beeverycreative/helloBEEprusa-hardware/helloBEEprusa-addon_printed_parts/statibilty_feet-middle_left.stl

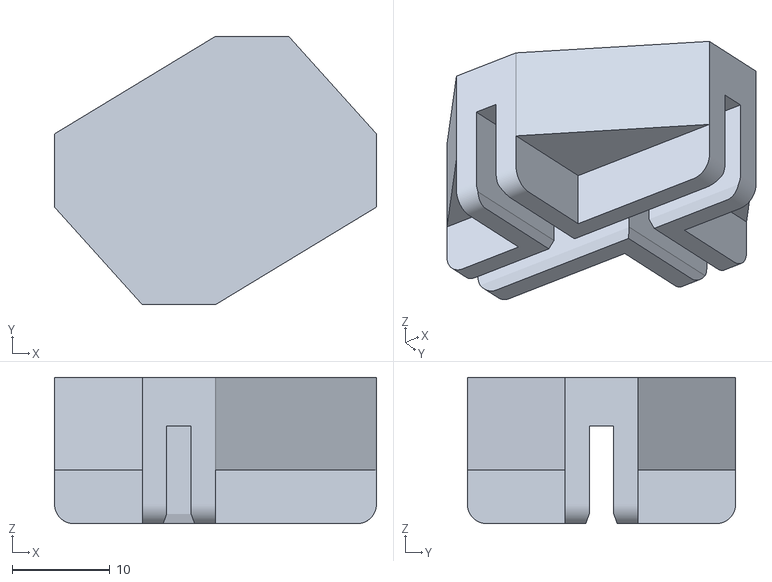
[picture p2: CAD file, 2015-11-10]
helloBEEprusa-addon_printed_parts/statibilty_feet-middle_left.stl
33.0 x 27.5 x 15.0
