beeverycreative/helloBEEprusa-hardware/helloBEEprusa-autocalibration_addon_printed_parts/Auto_level_arm.STL

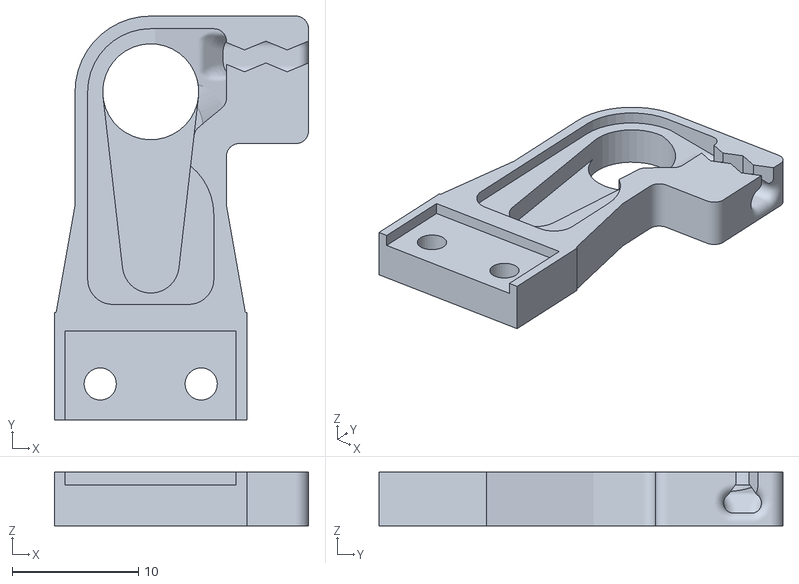
[picture p3: CAD file, 2018-11-13]
helloBEEprusa-autocalibration_addon_printed_parts/Auto_level_arm.STL
20.1 x 32.0 x 4.25
