beeverycreative/helloBEEprusa-hardware/helloBEEprusa-printed_parts/BLOWER.step

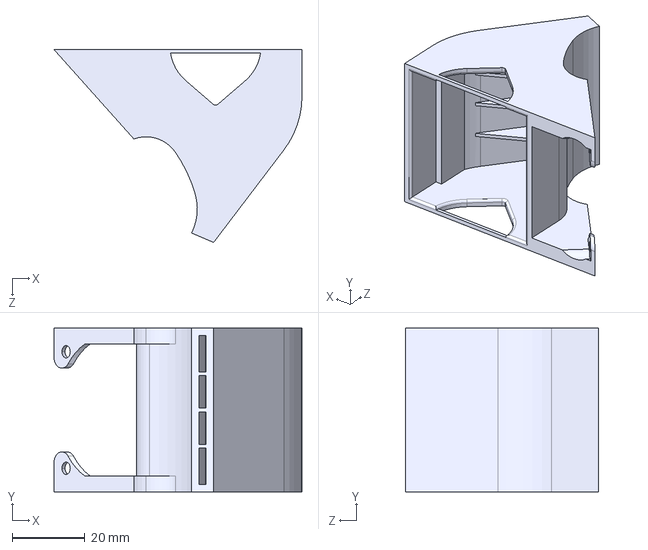
[picture p4: CAD file, 2016-04-29]
helloBEEprusa-printed_parts/BLOWER.step
68.1 x 45.0 x 53.0 mm
