beeverycreative/helloBEEprusa-hardware/helloBEEprusa-sources/Step/Assem_mesa.stp

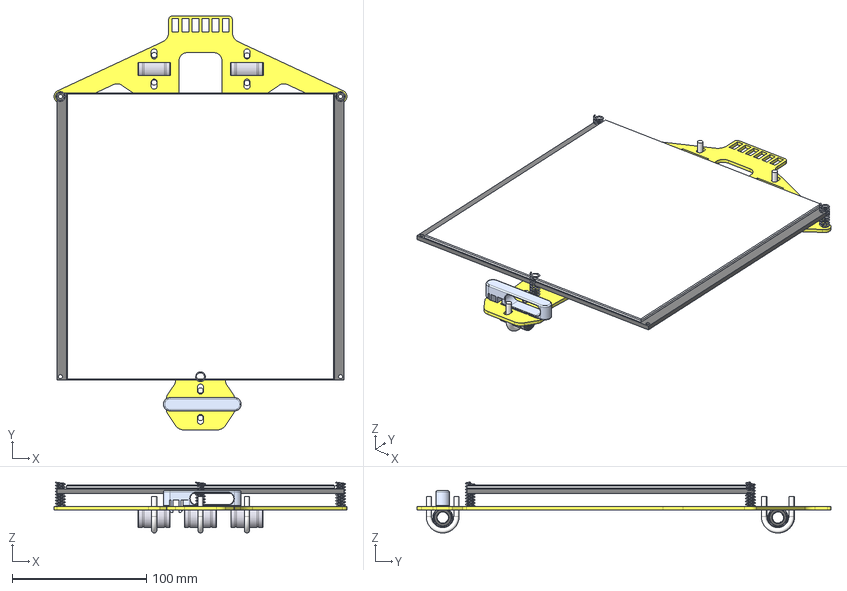
[picture p6: CAD file, 2016-10-18]
helloBEEprusa-sources/Step/Assem_mesa.stp
218.5 x 308.8 x 38.0 mm
endstop_lever_V2.1_03102016_0
Mola mesa_0 x 3
MK3_heated_bed_0
GrampoU_0 x 3
LU8MM_0 x 3
Base_mesa_0
Vidro_Temperado
