beeverycreative/helloBEEprusa-hardware/helloBEEprusa-autocalibration_addon_printed_parts/Auto_level_body.STL

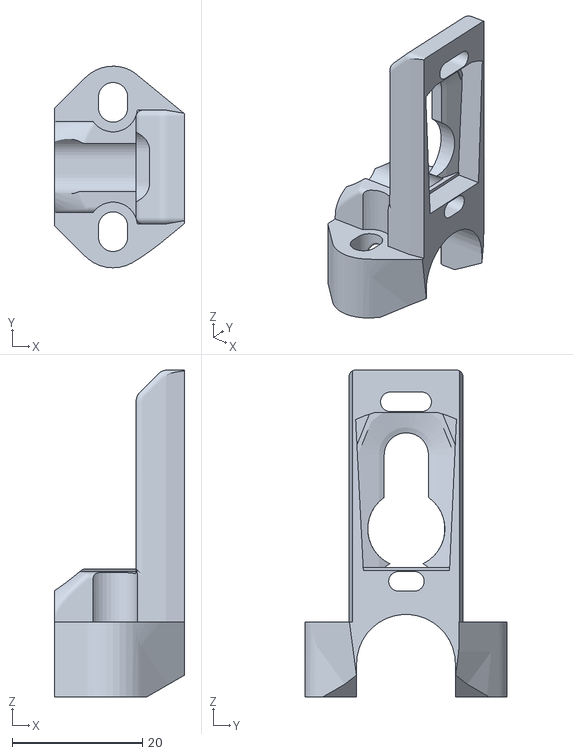
[picture p7: CAD file, 2018-11-13]
helloBEEprusa-autocalibration_addon_printed_parts/Auto_level_body.STL
20.0 x 31.0 x 50.3
