beeverycreative/helloBEEprusa-hardware/helloBEEprusa-printed_parts/XY_END_STOP_LEVER.step

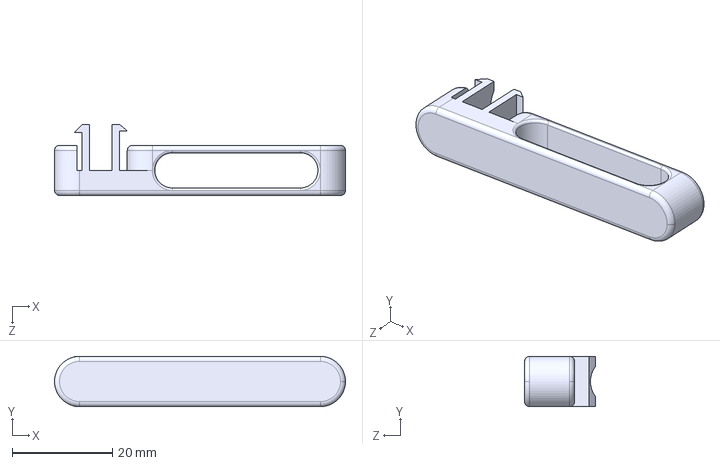
[picture p8: CAD file, 2016-04-29]
helloBEEprusa-printed_parts/XY_END_STOP_LEVER.step
58.0 x 10.0 x 14.2 mm
