beeverycreative/helloBEEprusa-hardware/helloBEEprusa-sources/dxf e dwg/Planificação HelloBeePrusa_V4.DXF

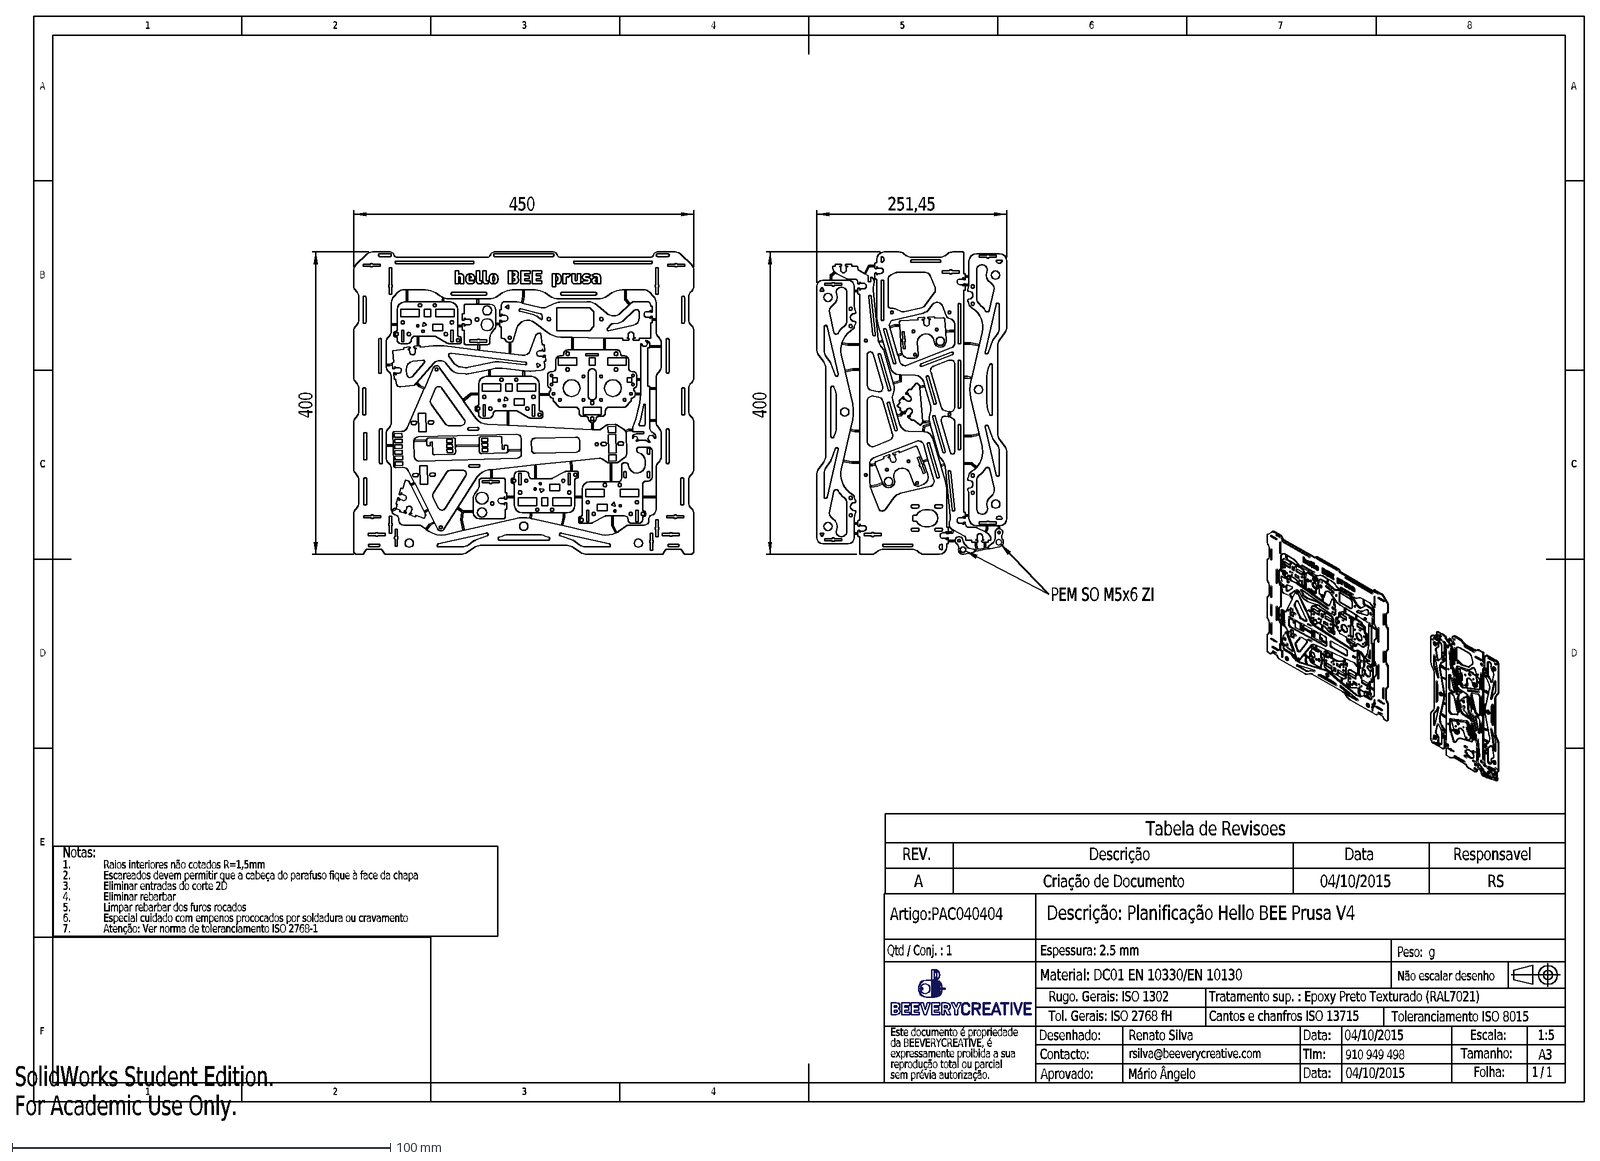
[picture p9: CAD file, 2016-10-18]
helloBEEprusa-sources/dxf e dwg/Planificação HelloBeePrusa_V4.DXF
Notas:
Raios interiores não cotados R=1,5mm
1.
Escareados devem permitir que a cabeça do parafuso fique à face da chapa
2.
Eliminar entradas do corte 2D
3.
Eliminar rebarbar
4.
Limpar rebarbar dos furos rocados
5.
Especial cuidado com empenos prococados por soldadura ou cravamento
6.
Atenção: Ver norma de toleranciamento ISO 2768-1
7.
D
E
F
C
1
2
3
4
B
A
5
6
7
8
Peso: g
Material: DC01 EN 10330/EN 10130
A3
1 / 1
1:5
Folha:
Tamanho:
Escala:
Este documento é propriedade
da BEEVERYCREATIVE, é
expressamente proibida a sua
reprodução total ou parcial
sem prévia autorização.
Desenhado:
Contacto:
Aprovado:
Data:
Tlm:
Qtd / Conj. : 1
Toleranciamento ISO 8015
Tol. Gerais: ISO 2768 fH
Cantos e chanfros ISO 13715
Rugo. Gerais: ISO 1302
Tratamento sup. : Epoxy Preto Texturado (RAL7021)
Artigo:PAC040404
Descrição: Planificação Hello BEE Prusa V4
Não escalar desenho
04/10/2015
Espessura: 2.5 mm
Renato Silva
rsilva@beeverycreative.com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
