beeverycreative/helloBEEprusa-hardware/helloBEEprusa-addon_printed_parts/stability_feet-corner.stl

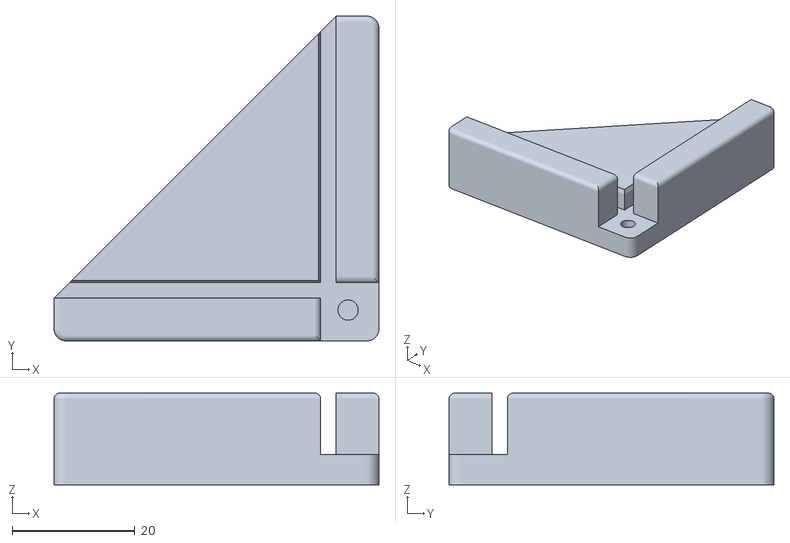
[picture p10: CAD file, 2015-11-10]
helloBEEprusa-addon_printed_parts/stability_feet-corner.stl
53.0 x 53.0 x 15.0
