beeverycreative/helloBEEprusa-hardware/helloBEEprusa-printed_parts/ENDSTOP_SUPORT.step

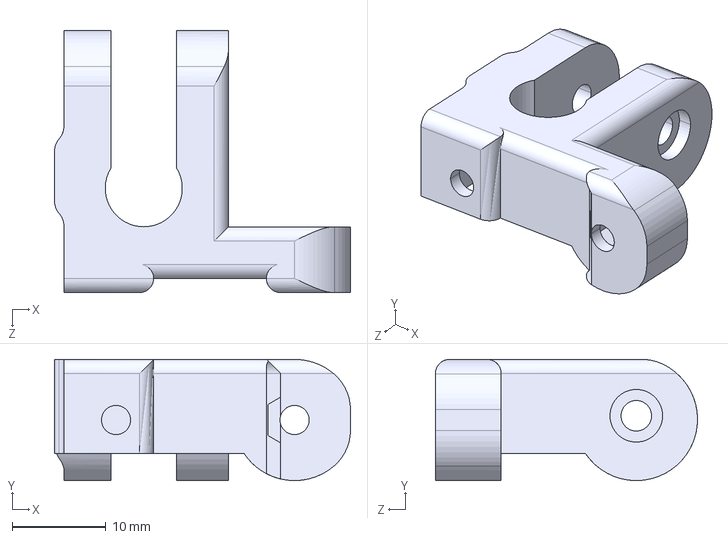
[picture p11: CAD file, 2016-04-29]
helloBEEprusa-printed_parts/ENDSTOP_SUPORT.step
31.5 x 12.9 x 27.9 mm
