beeverycreative/helloBEEprusa-hardware/helloBEEprusa-sources/dxf e dwg/Planificação HelloBeePrusa_V3 - Principal.DXF

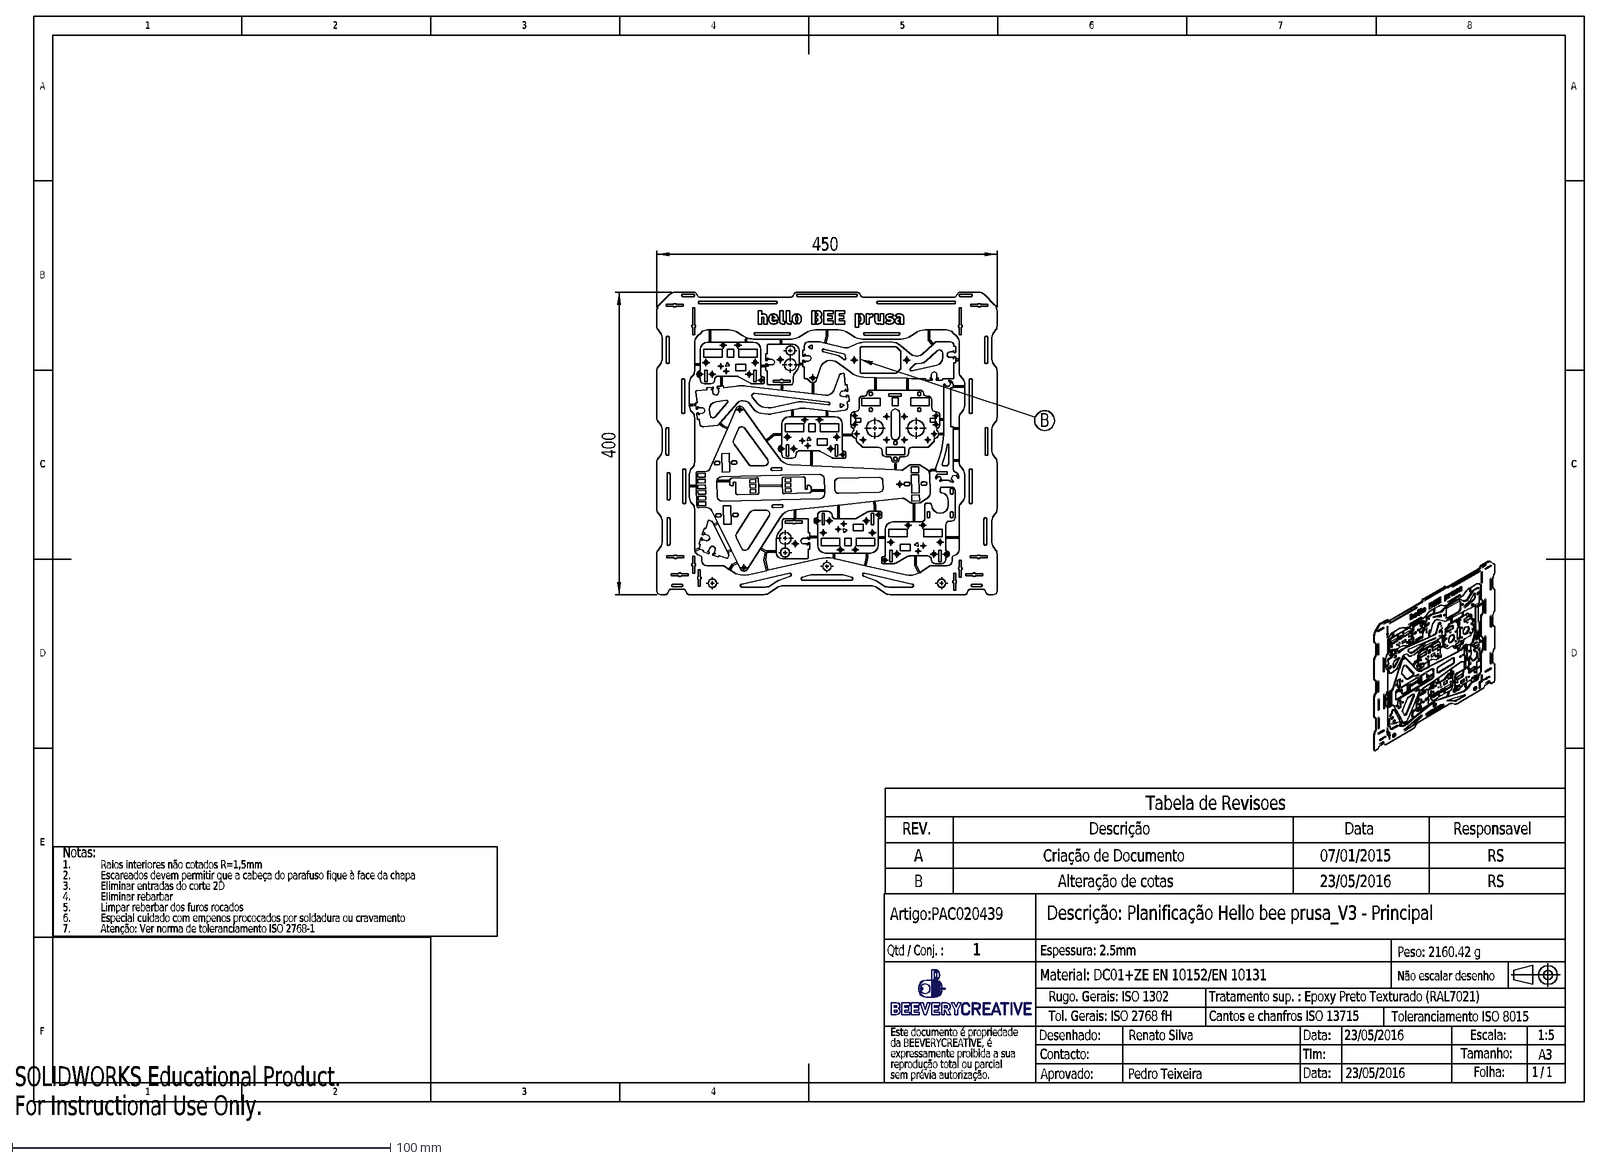
[picture p12: CAD file, 2016-10-18]
helloBEEprusa-sources/dxf e dwg/Planificação HelloBeePrusa_V3 - Principal.DXF
Notas:
Raios interiores não cotados R=1,5mm
1.
Escareados devem permitir que a cabeça do parafuso fique à face da chapa
2.
Eliminar entradas do corte 2D
3.
Eliminar rebarbar
4.
Limpar rebarbar dos furos rocados
5.
Especial cuidado com empenos prococados por soldadura ou cravamento
6.
Atenção: Ver norma de toleranciamento ISO 2768-1
7.
D
E
F
C
1
2
3
4
B
A
5
6
7
8
Peso: 2160.42 g
Material: DC01+ZE EN 10152/EN 10131
A3
1 / 1
1:5
Folha:
Tamanho:
Escala:
Este documento é propriedade
da BEEVERYCREATIVE, é
expressamente proibida a sua
reprodução total ou parcial
sem prévia autorização.
Desenhado:
Contacto:
Aprovado:
Data:
Tlm:
Qtd / Conj. :
Toleranciamento ISO 8015
Tol. Gerais: ISO 2768 fH
Cantos e chanfros ISO 13715
Rugo. Gerais: ISO 1302
Tratamento sup. : Epoxy Preto Texturado (RAL7021)
Artigo:PAC020439
Descrição: Planificação Hello bee prusa_V3 - Principal
Não escalar desenho
23/05/2016
Espessura: 2.5mm
Renato Silva
Pedro Teixeira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
