beeverycreative/helloBEEprusa-hardware/helloBEEprusa-sources/Step/Assem_eixo_X.stp

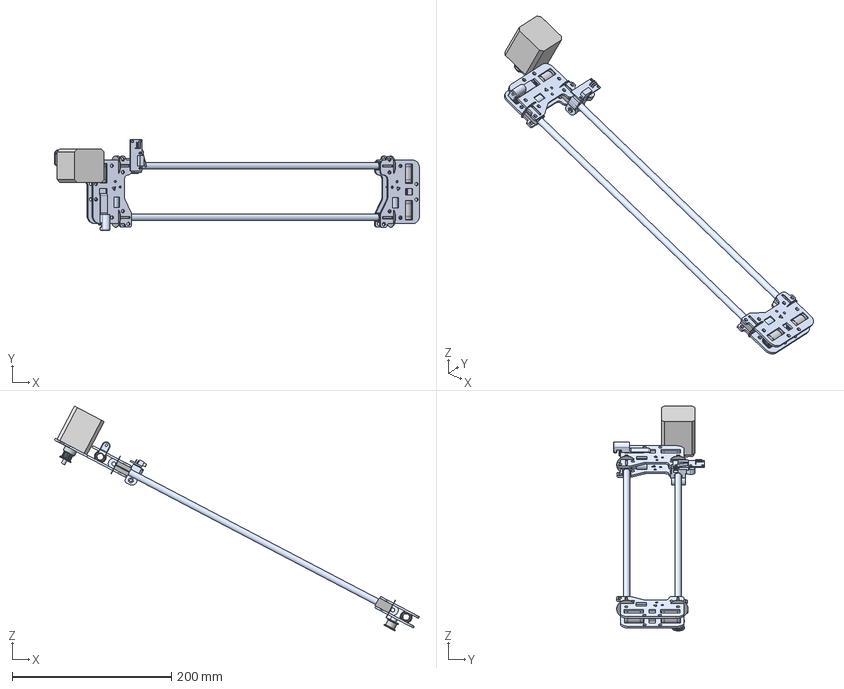
[picture p13: CAD file, 2016-10-18]
helloBEEprusa-sources/Step/Assem_eixo_X.stp
458.4 x 114.0 x 282.4 mm
Pulley_GT2_20_Tooth_0
endstop_suport_V2_23102015_0
endstop_0
7.0.2 - Polia_livre_0
Rolamento_638_4_2Z_2_03_0
endstop_lever_V2_ajustavel_03102016_1
Femea_igus_1 x 2
Espacador_Essentra_L7xd4.3xD8_0
LU8MM_1 x 4
Placa_Eixo_X1_1 x 3
Placa_Eixo_X3_1
Motor_Nema17_SY42STH47-1684A_0
Guia_M8_XPRT_1 x 2
Suporte_guias_1 x 4
