beeverycreative/helloBEEprusa-hardware/helloBEEprusa-printed_parts/ADJUSTMENT_FOR_BEARING_COVER.step

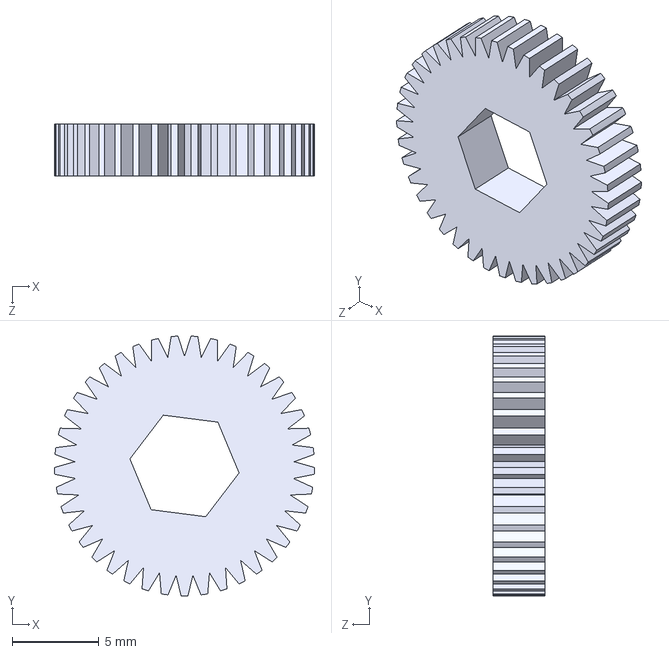
[picture p14: CAD file, 2016-04-29]
helloBEEprusa-printed_parts/ADJUSTMENT_FOR_BEARING_COVER.step
15.0 x 15.0 x 3.00 mm
