beeverycreative/helloBEEprusa-hardware/helloBEEprusa-printed_parts/Z_SUPPORT_RIGHT.step

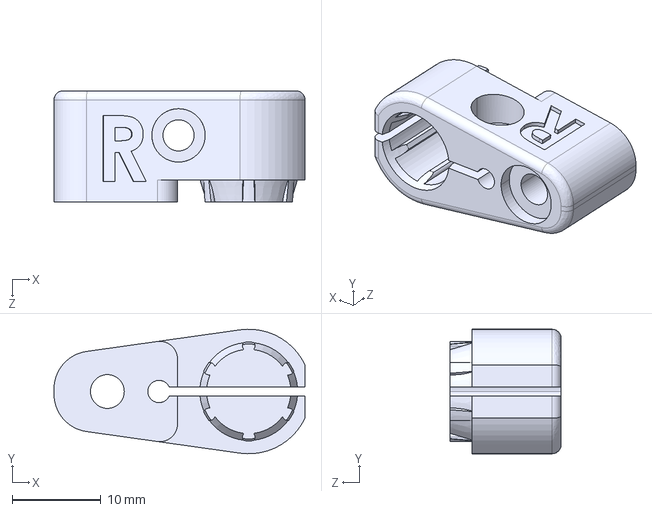
[picture p15: CAD file, 2016-04-29]
helloBEEprusa-printed_parts/Z_SUPPORT_RIGHT.step
28.2 x 14.0 x 12.5 mm
