beeverycreative/helloBEEprusa-hardware/helloBEEprusa-printed_parts/CLAMP.step

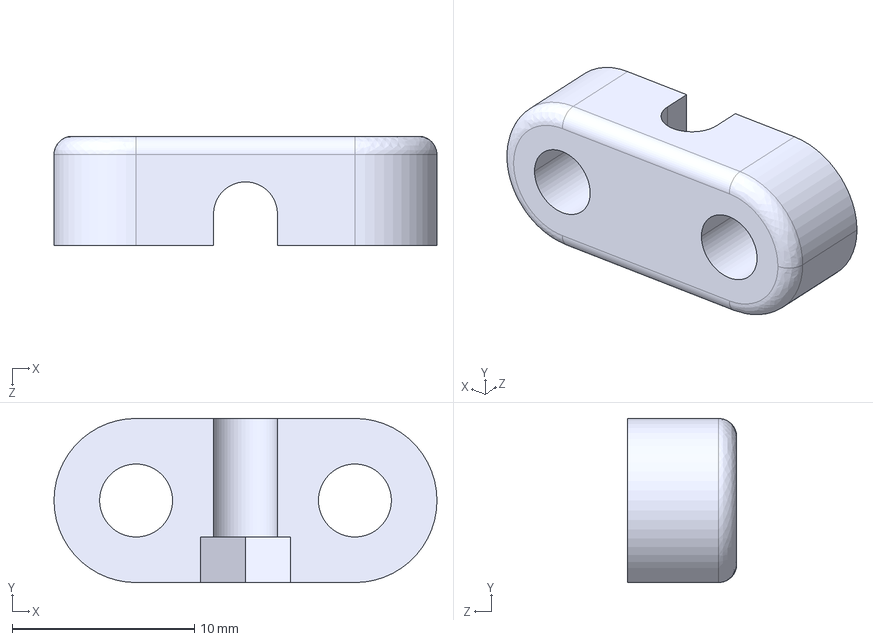
[picture p16: CAD file, 2016-04-29]
helloBEEprusa-printed_parts/CLAMP.step
21.0 x 9.00 x 6.00 mm
