beeverycreative/helloBEEprusa-hardware/helloBEEprusa-addon_printed_parts/enclosure_for_electronics-V4.stl

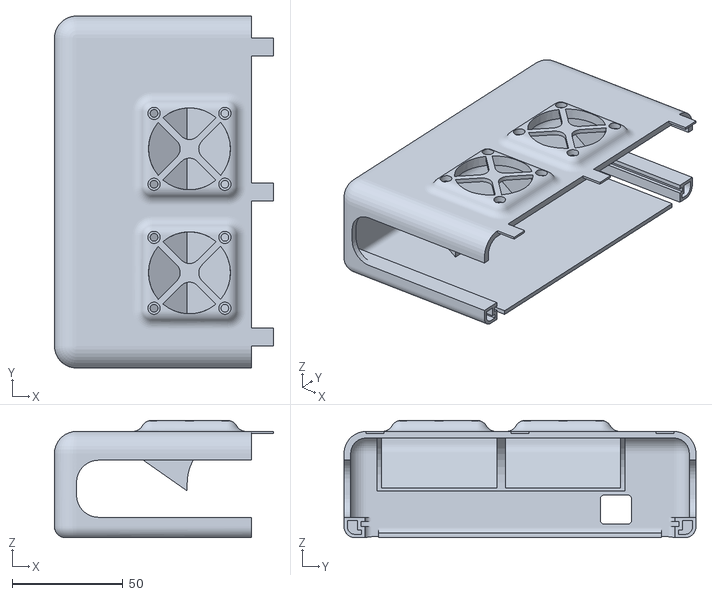
[picture p17: CAD file, 2015-11-04]
helloBEEprusa-addon_printed_parts/enclosure_for_electronics-V4.stl
99.0 x 159.0 x 53.0
