beeverycreative/helloBEEprusa-hardware/helloBEEprusa-printed_parts/DISPLAY_SPACER.step

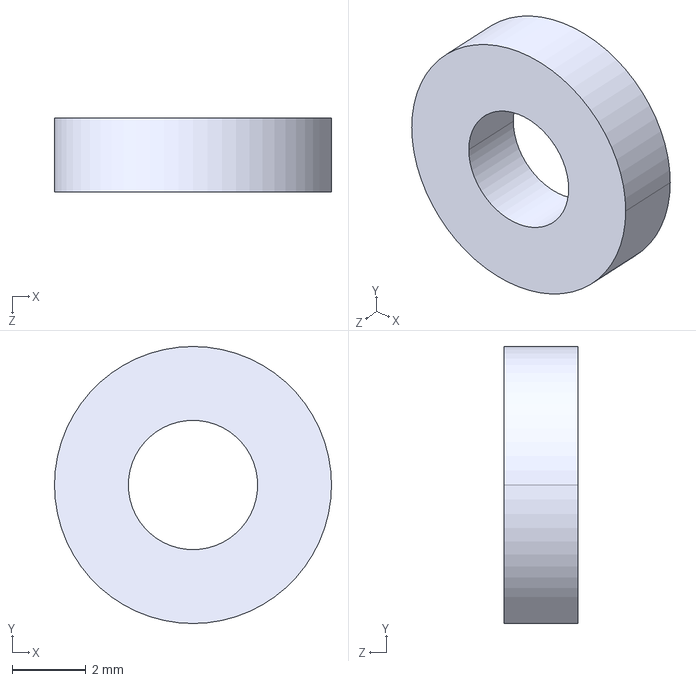
[picture p18: CAD file, 2016-04-29]
helloBEEprusa-printed_parts/DISPLAY_SPACER.step
7.50 x 7.50 x 2.00 mm
