beeverycreative/helloBEEprusa-hardware/helloBEEprusa-addon_printed_parts/two_spools_holder-v5.stl

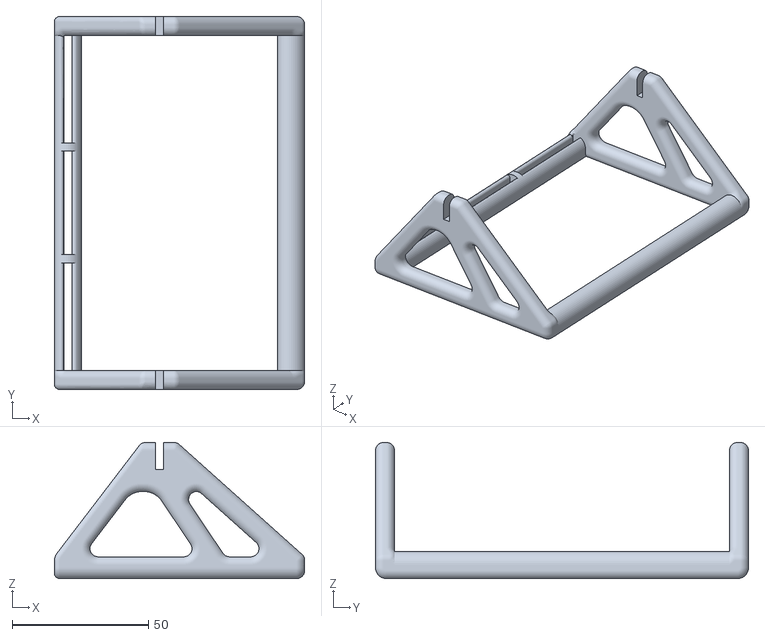
[picture p19: CAD file, 2015-08-05]
helloBEEprusa-addon_printed_parts/two_spools_holder-v5.stl
92.0 x 137.0 x 50.0
