beeverycreative/helloBEEprusa-hardware/helloBEEprusa-printed_parts/PCB_SPACER.step

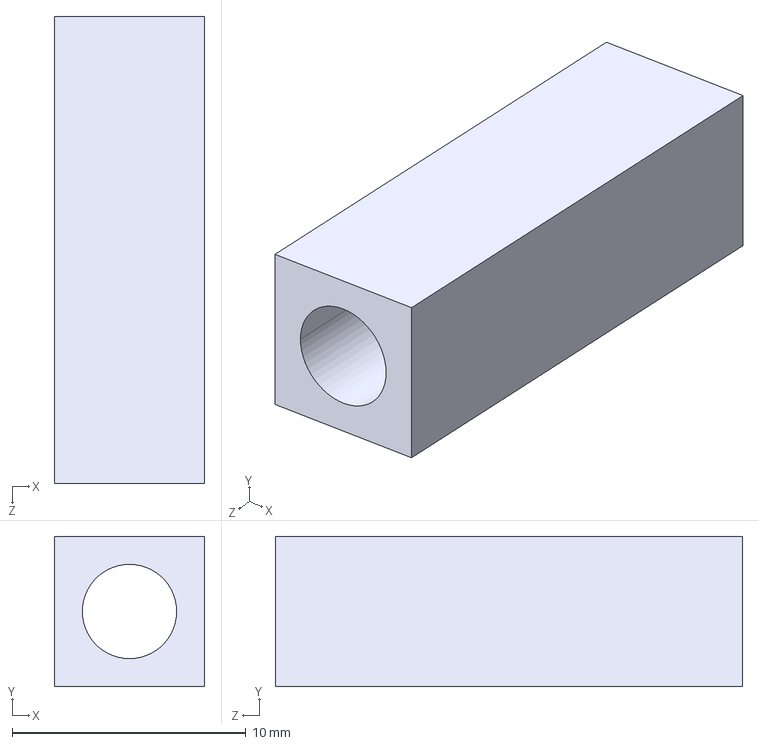
[picture p20: CAD file, 2016-04-29]
helloBEEprusa-printed_parts/PCB_SPACER.step
6.44 x 6.44 x 20.0 mm
