beeverycreative/helloBEEprusa-hardware/helloBEEprusa-addon_printed_parts/lcd_support-v5.stl

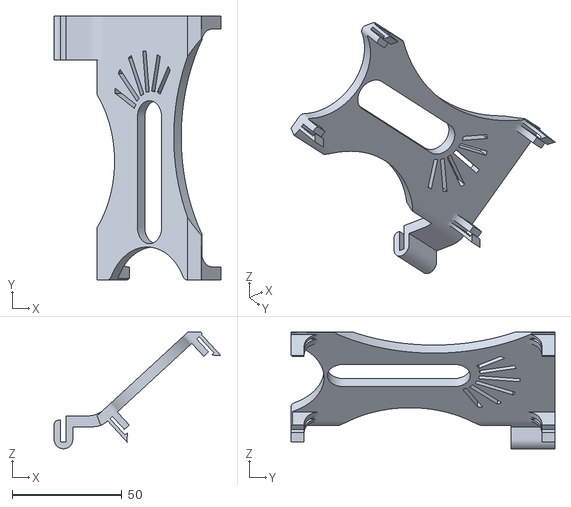
[picture p21: CAD file, 2015-08-05]
helloBEEprusa-addon_printed_parts/lcd_support-v5.stl
75.8 x 120.0 x 53.0
