beeverycreative/helloBEEprusa-hardware/helloBEEprusa-printed_parts/Z_AXIS_SUPPORT.step

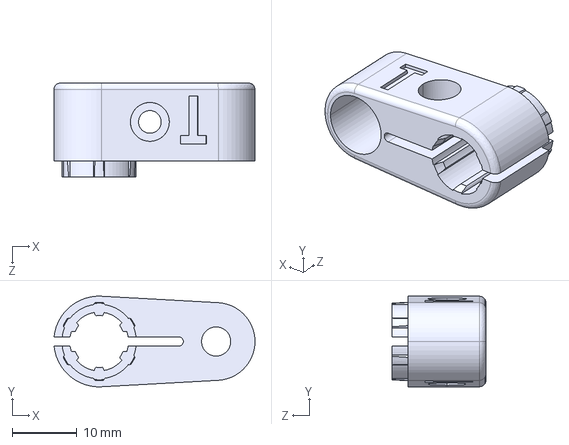
[picture p22: CAD file, 2016-04-29]
helloBEEprusa-printed_parts/Z_AXIS_SUPPORT.step
31.0 x 14.0 x 14.5 mm
