beeverycreative/helloBEEprusa-hardware/helloBEEprusa-addon_printed_parts/logo-hello.stl

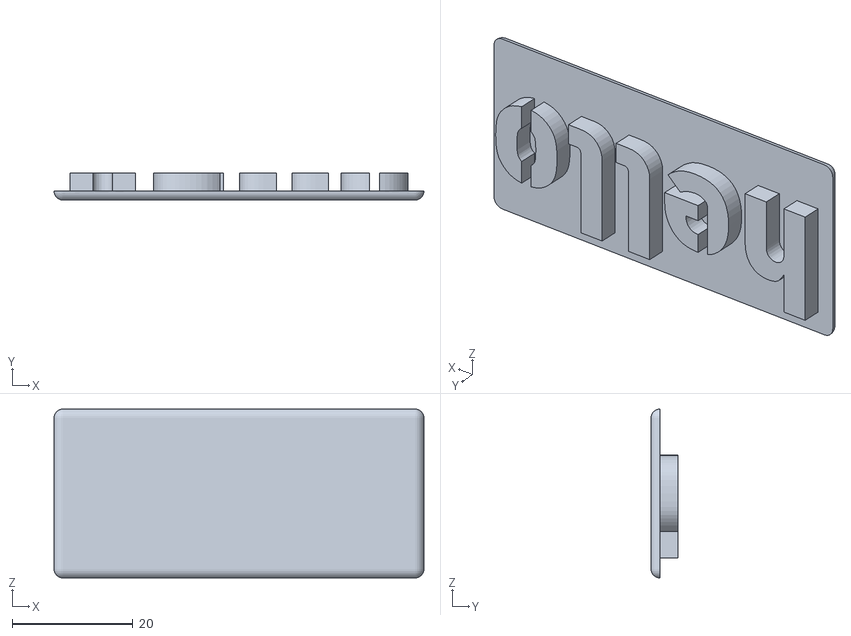
[picture p23: CAD file, 2015-08-05]
helloBEEprusa-addon_printed_parts/logo-hello.stl
61.3 x 4.50 x 28.0
