beeverycreative/helloBEEprusa-hardware/helloBEEprusa-printed_parts/X_SUPPORT.step

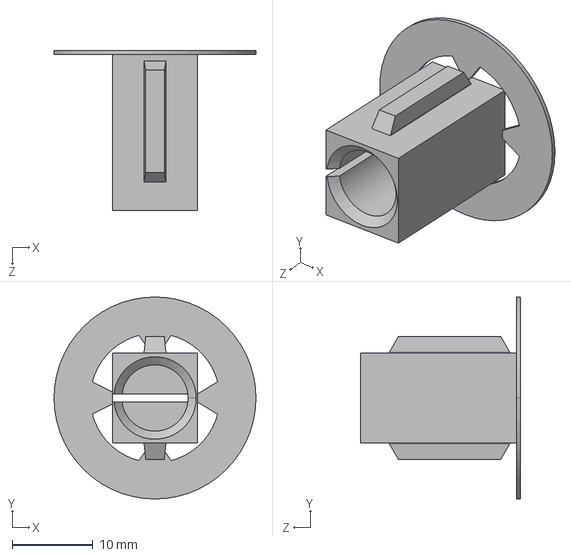
[picture p24: CAD file, 2016-04-29]
helloBEEprusa-printed_parts/X_SUPPORT.step
25.0 x 25.0 x 19.8 mm
