beeverycreative/helloBEEprusa-hardware/helloBEEprusa-addon_printed_parts/logo-bee.stl

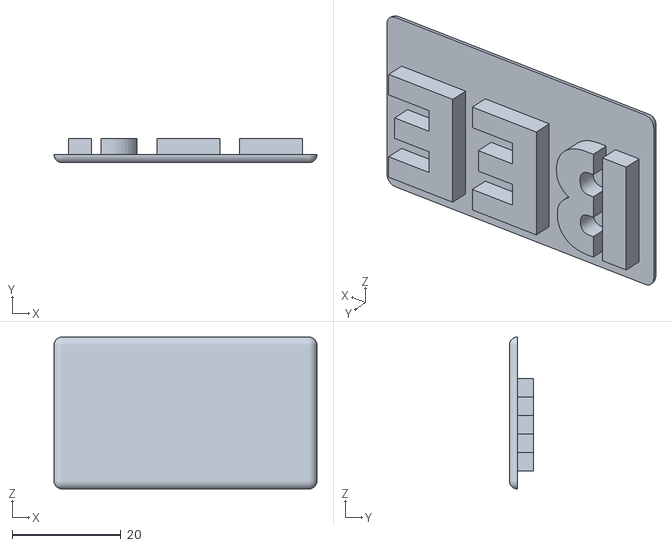
[picture p25: CAD file, 2015-08-05]
helloBEEprusa-addon_printed_parts/logo-bee.stl
48.4 x 4.50 x 28.0
