beeverycreative/helloBEEprusa-hardware/helloBEEprusa-printed_parts/SWITCH_ONOFF_BOX.step

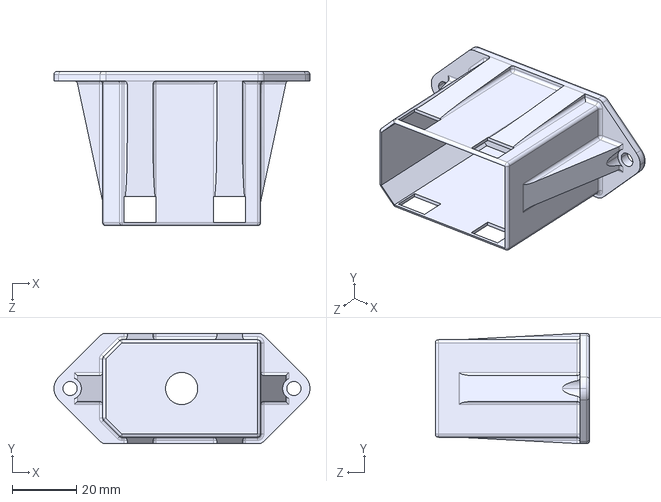
[picture p26: CAD file, 2016-04-29]
helloBEEprusa-printed_parts/SWITCH_ONOFF_BOX.step
79.5 x 34.3 x 48.0 mm
