beeverycreative/helloBEEprusa-hardware/helloBEEprusa-addon_printed_parts/logo-prusa.stl

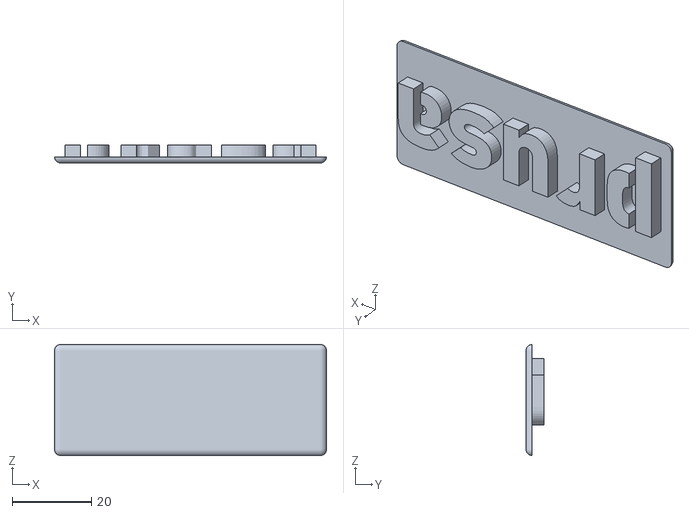
[picture p27: CAD file, 2015-08-05]
helloBEEprusa-addon_printed_parts/logo-prusa.stl
68.5 x 4.50 x 28.0
