beeverycreative/helloBEEprusa-hardware/helloBEEprusa-printed_parts/Z_SUPPORT_LEFT.step

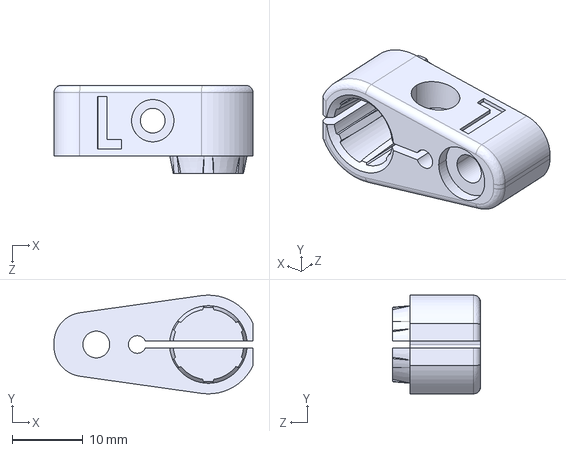
[picture p28: CAD file, 2016-04-29]
helloBEEprusa-printed_parts/Z_SUPPORT_LEFT.step
28.2 x 14.0 x 12.5 mm
