beeverycreative/helloBEEprusa-hardware/helloBEEprusa-printed_parts/Y_SUPPORT.step

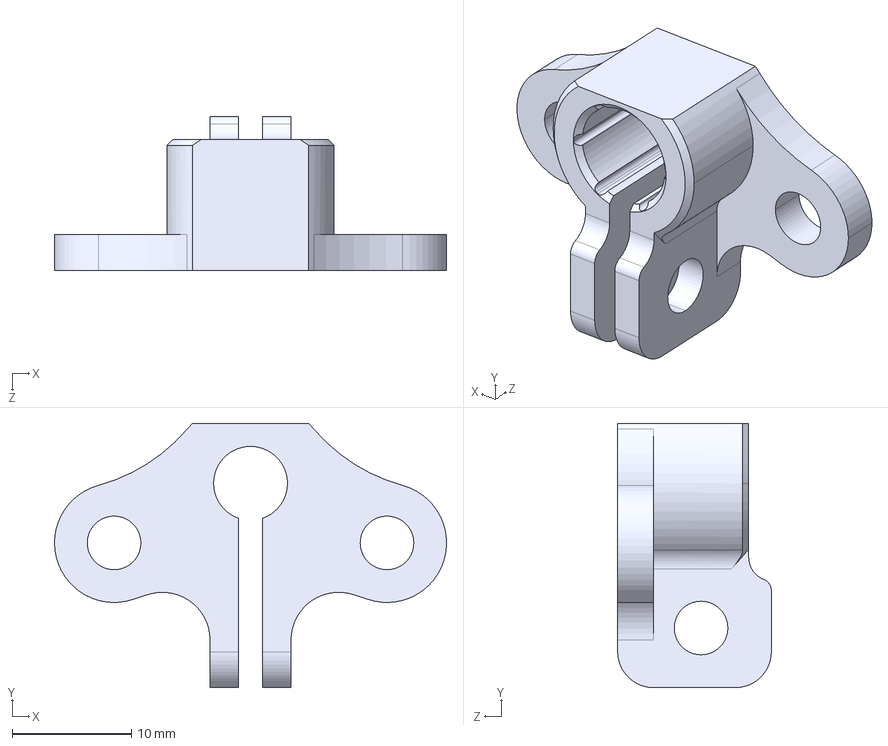
[picture p29: CAD file, 2016-04-29]
helloBEEprusa-printed_parts/Y_SUPPORT.step
32.9 x 22.2 x 12.9 mm
