beeverycreative/helloBEEprusa-hardware/helloBEEprusa-printed_parts/Z_ADJUSTABLE_END_STOP_LEVER.step

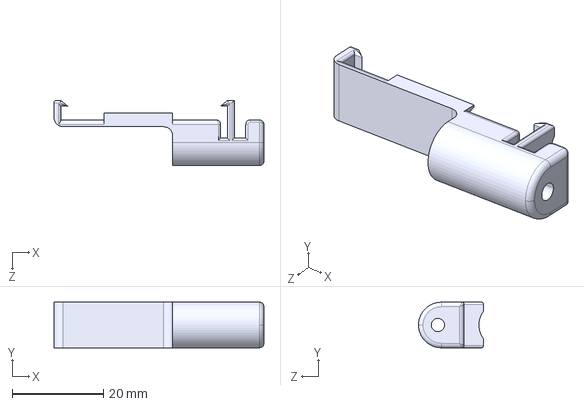
[picture p30: CAD file, 2016-04-29]
helloBEEprusa-printed_parts/Z_ADJUSTABLE_END_STOP_LEVER.step
46.0 x 10.0 x 14.3 mm
