beeverycreative/helloBEEprusa-hardware/helloBEEprusa-printed_parts/FAN_SUPPORT.step

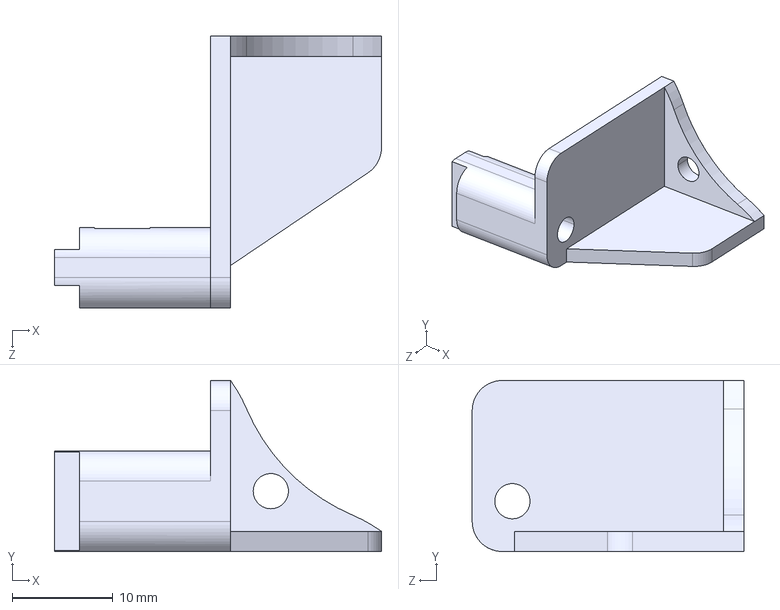
[picture p31: CAD file, 2016-04-29]
helloBEEprusa-printed_parts/FAN_SUPPORT.step
32.5 x 17.0 x 27.0 mm
