beeverycreative/helloBEEprusa-hardware/helloBEEprusa-printed_parts/ENDSTOP_SUPORT-V3.STL

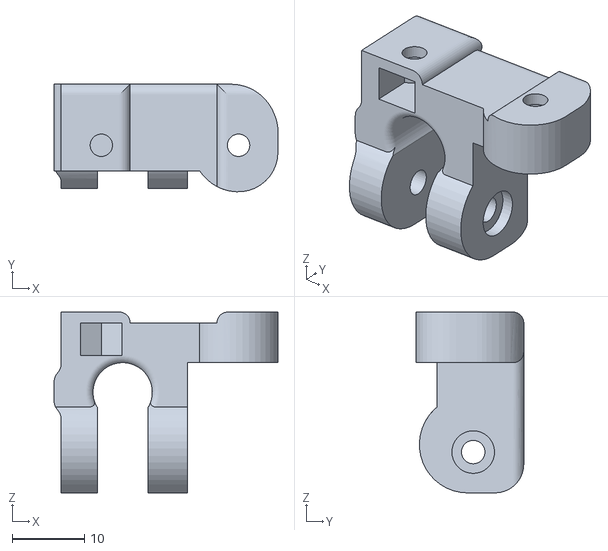
[picture p32: CAD file, 2016-01-05]
helloBEEprusa-printed_parts/ENDSTOP_SUPORT-V3.STL
31.0 x 14.9 x 25.0
