beeverycreative/helloBEEprusa-hardware/(list of files, cad)

Other CAD files:
helloBEEprusa-addon_printed_parts/stability_feet-middle_right.stl
helloBEEprusa-addon_printed_parts/statibilty_feet-middle_right.stl
helloBEEprusa-printed_parts/ADJUSTMENT_FOR_BEARING_COVER.STL
helloBEEprusa-printed_parts/BLOWER.STL
helloBEEprusa-printed_parts/CLAMP.STL
helloBEEprusa-printed_parts/DISPLAY_SPACER.STL
helloBEEprusa-printed_parts/FAN_SUPPORT.STL
helloBEEprusa-printed_parts/PCB_SPACER.STL
helloBEEprusa-printed_parts/SWITCH_ONOFF_BOX.stl
helloBEEprusa-printed_parts/XY_END_STOP_LEVER.STL
helloBEEprusa-printed_parts/X_SUPPORT.STL
helloBEEprusa-printed_parts/Y_SUPPORT.STL
helloBEEprusa-printed_parts/Z_ADJUSTABLE_END_STOP_LEVER.STL
helloBEEprusa-printed_parts/Z_AXIS_SUPPORT.STL
helloBEEprusa-printed_parts/Z_SUPPORT_LEFT.STL
helloBEEprusa-printed_parts/Z_SUPPORT_RIGHT.STL
helloBEEprusa-sources/Igs/Assem_mesa.igs
helloBEEprusa-sources/Parasolid/Assem_eixo_X.x_t
helloBEEprusa-sources/Parasolid/Assem_mesa.x_t
helloBEEprusa-sources/Parasolid/Assembly do Extrusor.x_t
helloBEEprusa-sources/dxf e dwg/Planificação HelloBeePrusa_V3 - Complementar.dwg
helloBEEprusa-sources/dxf e dwg/Planificação HelloBeePrusa_V3 - Principal.dwg
helloBEEprusa-sources/dxf e dwg/Planificação HelloBeePrusa_V4.dwg
