beeverycreative/helloBEEprusa-hardware/(commit log)

2015-07-31 Initial files.
    [ADJUSTABLE_Z_END_STOP.STL, ADJUSTMENT_FOR_BEARING_COVER.STL, BLOWER.STL, CLAMP.STL, DISPLAY_SPACER.STL, END_STOP_SUPORT.STL, FAN_SUPPORT.STL, GUIDE_SHOE.STL]
2015-08-05 Added Addon printed parts
    [BEE.STL, Suporte_LCD_V5.STL, Suporte_universal_prusa_dois_rolos_V5.stl, hello.STL, pes_antivibratorios.stl, prusa.STL]
2015-09-17 Some improvements to the printed parts.
    [BLOWER.STL, CLAMP.STL, ENDSTOP_SUPORT.STL, GUIDE_SHOE.STL]
2015-11-03 Updated the ENDSTOP_SUPORT to V2. Deleted the PNG files.
    [ENDSTOP_SUPORT-V2.STL]
2015-11-03 Deleted old STL files for ENDSTOP_SUPORT and PNG files.
    [ENDSTOP_SUPORT.STL, END_STOP_SUPORT.STL]
2015-11-04 Added enclosure for electronics.
    [Enclosure_for_electronics-V4.stl]
2015-11-09 Removed PNG files and changed the name of the files to EN
    [anti_vibration_feet.stl, enclosure_for_electronics-V4.stl, lcd_support-v5.stl, logo-bee.stl, logo-hello.stl, logo-prusa.stl, two_spools_holder-v5.stl]
2015-11-10 Updated the feets to give more stability.
    [anti_vibration_feet.stl, statibilty_feet-corner.stl, statibilty_feet-middle_left.stl, statibilty_feet-middle_right.stl]
2015-11-10 Small name fix
    [stability_feet-corner.stl, stability_feet-middle_left.stl, stability_feet-middle_right.stl]
2016-01-05 Update to ENDSTOP_SUPPORT
    [ENDSTOP_SUPORT-V2.STL, ENDSTOP_SUPORT-V3.STL]
2016-01-11 Revert "Small name fix"
    This reverts commit 385b05c300a7ec63e1851ed3455209dcc6d71034.
    [statibilty_feet-corner.stl, statibilty_feet-middle_left.stl, statibilty_feet-middle_right.stl]
2016-01-15 Updated printed parts
    [ADJUSTABLE_Z_END_STOP.STL, ADJUSTMENT_FOR_BEARING_COVER.STL, BLOWER.STL, DISPLAY_SPACER.STL, ENDSTOP_SUPORT.STL, FAN_SUPPORT.STL, GUIDE_SHOE.STL, PCB_SPACER.STL]
2016-04-29 Added STEP files for the printed parts
    [ADJUSTMENT_FOR_BEARING_COVER.step, BLOWER.step, CLAMP.step, DISPLAY_SPACER.step, ENDSTOP_SUPORT.step, FAN_SUPPORT.step, PCB_SPACER.step, SWITCH_ONOFF_BOX.step]
2016-10-18 Added more source files
    [Assem_eixo_X.stp, Assem_eixo_X.x_t, Assem_mesa.igs, Assem_mesa.stp, Assem_mesa.x_t, Assembly do Extrusor.stp, Assembly do Extrusor.x_t, Planificação HelloBeePrusa_V3 - Complementar.DXF]
2018-11-13 Added Autocalibration STL files
    [Auto_level_arm.STL, Auto_level_body.STL]
